tachesimazzoca/retro-devices/usb-sfc-pad/kicad/usb_sfc_pad/3dmodels/0533980271.stp

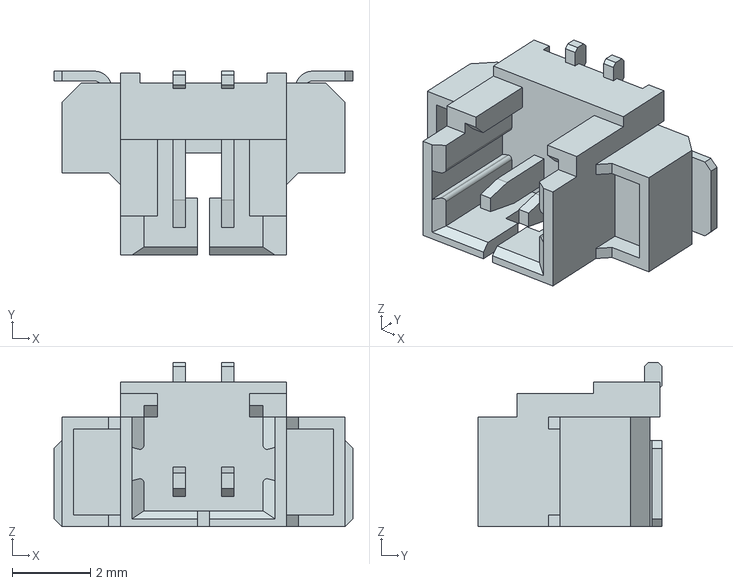
[picture p1: CAD file, 2025-09-26]
usb-sfc-pad/kicad/usb_sfc_pad/3dmodels/0533980271.stp
7.65 x 4.70 x 4.20 mm
