tachesimazzoca/retro-devices/usb-sfc-pad/kicad/usb_sfc_pad/3dmodels/0532610571.stp

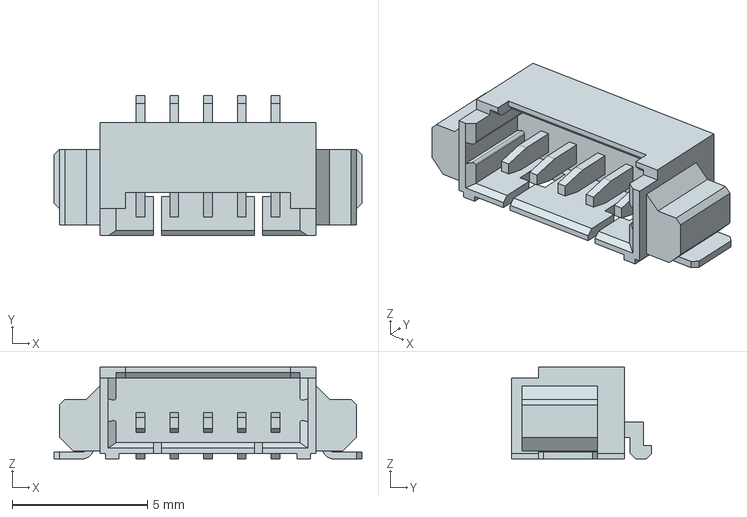
[picture p2: CAD file, 2025-09-26]
usb-sfc-pad/kicad/usb_sfc_pad/3dmodels/0532610571.stp
11.4 x 5.20 x 3.40 mm
