tachesimazzoca/retro-devices/usb-sfc-pad/kicad/usb_sfc_pad/usb_sfc_pad.kicad_pcb

## KiCad design usb-sfc-pad/kicad/usb_sfc_pad/usb_sfc_pad.kicad_pcb (2025-09-27)

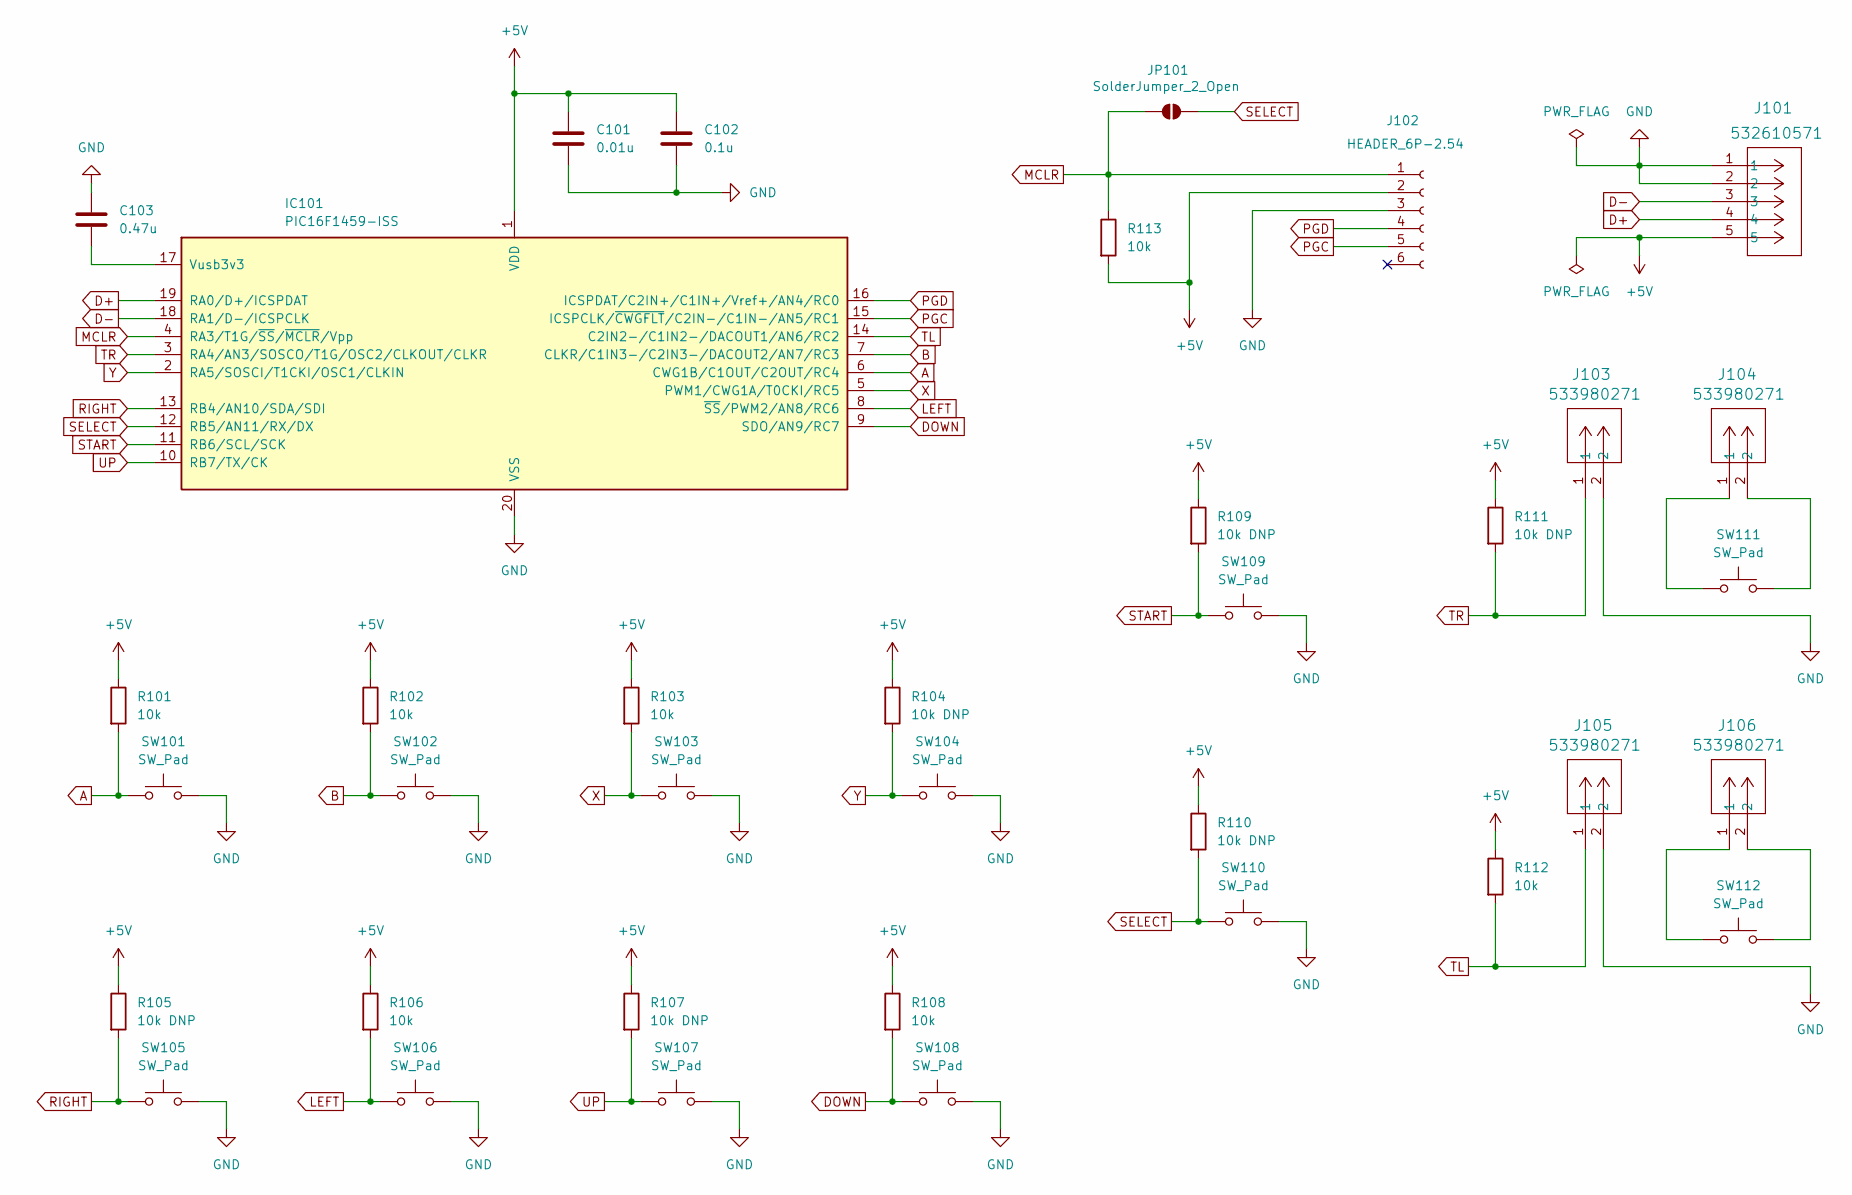
[picture p3: schematic usb_sfc_pad.kicad_sch, USB SFC Pad]

Parts:
C101: 0.01u; C_0402_1005Metric
C102: 0.1u; C_0402_1005Metric
C103: 0.47u; C_0402_1005Metric
IC101: PIC16F1459-ISS; SSOP-20_5.3x7.2mm_P0.65mm
J101: 532610571; CONN_532610001-SD_05_MOL
J102: HEADER_6P-2.54; PinHeader_1x06_P2.54mm_Vertical
J103, J104, J105, J106: 533980271; CONN02_533980271_MOL
JP101: SolderJumper_2_Open; SolderJumper-2_P1.3mm_Open_TrianglePad1.0x1.5mm
R101, R102, R103, R106, R108, R112, R113: 10k; R_0603_1608Metric
R104, R105, R107, R109, R110, R111: 10k DNP; R_0603_1608Metric
SW101, SW102, SW103, SW104, SW105, SW106, SW107, SW108, SW109, SW110, SW111, SW112: SW_Pad; SFC_Pad_F_NoSolder_5.5mm

Connections:
+5V: C101.1, C102.1, IC101.1 (VDD), J101.5, J102.2, R101.1, R102.1, R103.1, R104.1, R105.1, R106.1, R107.1, R108.1, R109.1, R110.1, R111.1, R112.1, R113.2
A: IC101.6 (CWG1B/C1OUT/C2OUT/RC4), R101.2, SW101.2
B: IC101.7 (CLKR/C1IN3-/C2IN3-/DACOUT2/AN7/RC3), R102.2, SW102.2
D+: IC101.19 (RA0/D+/ICSPDAT), J101.4
D-: IC101.18 (RA1/D-/ICSPCLK), J101.3
DOWN: IC101.9 (SDO/AN9/RC7), R108.2, SW108.1
GND: C101.2, C102.2, C103.1, IC101.20 (VSS), J101.1, J101.2, J102.3, J103.2, J105.2, SW101.1, SW102.1, SW103.1, SW104.1, SW105.2, SW106.1, SW107.2, SW108.2, SW109.2, SW110.2
LEFT: IC101.8 (~SS/PWM2/AN8/RC6), R106.2, SW106.2
MCLR: IC101.4 (RA3/T1G/~SS/~MCLR/Vpp), J102.1, JP101.1 (A), R113.1
unnamed: C103.2, IC101.17 (Vusb3v3)
unnamed: J104.1, SW111.1
unnamed: J104.2, SW111.2
unnamed: J106.1, SW112.1
unnamed: J106.2, SW112.2
PGC: IC101.15 (ICSPCLK/~CWGFLT/C2IN-/C1IN-/AN5/RC1), J102.5
PGD: IC101.16 (ICSPDAT/C2IN+/C1IN+/Vref+/AN4/RC0), J102.4
RIGHT: IC101.13 (RB4/AN10/SDA/SDI), R105.2, SW105.1
SELECT: IC101.12 (RB5/AN11/RX/DX), JP101.2 (B), R110.2, SW110.1
START: IC101.11 (RB6/SCL/SCK), R109.2, SW109.1
TL: IC101.14 (C2IN2-/C1IN2-/DACOUT1/AN6/RC2), J105.1, R112.2
TR: IC101.3 (RA4/AN3/SOSCO/T1G/OSC2/CLKOUT/CLKR), J103.1, R111.2
UP: IC101.10 (RB7/TX/CK), R107.2, SW107.1
X: IC101.5 (PWM1/CWG1A/T0CKI/RC5), R103.2, SW103.2
Y: IC101.2 (RA5/SOSCI/T1CKI/OSC1/CLKIN), R104.2, SW104.2

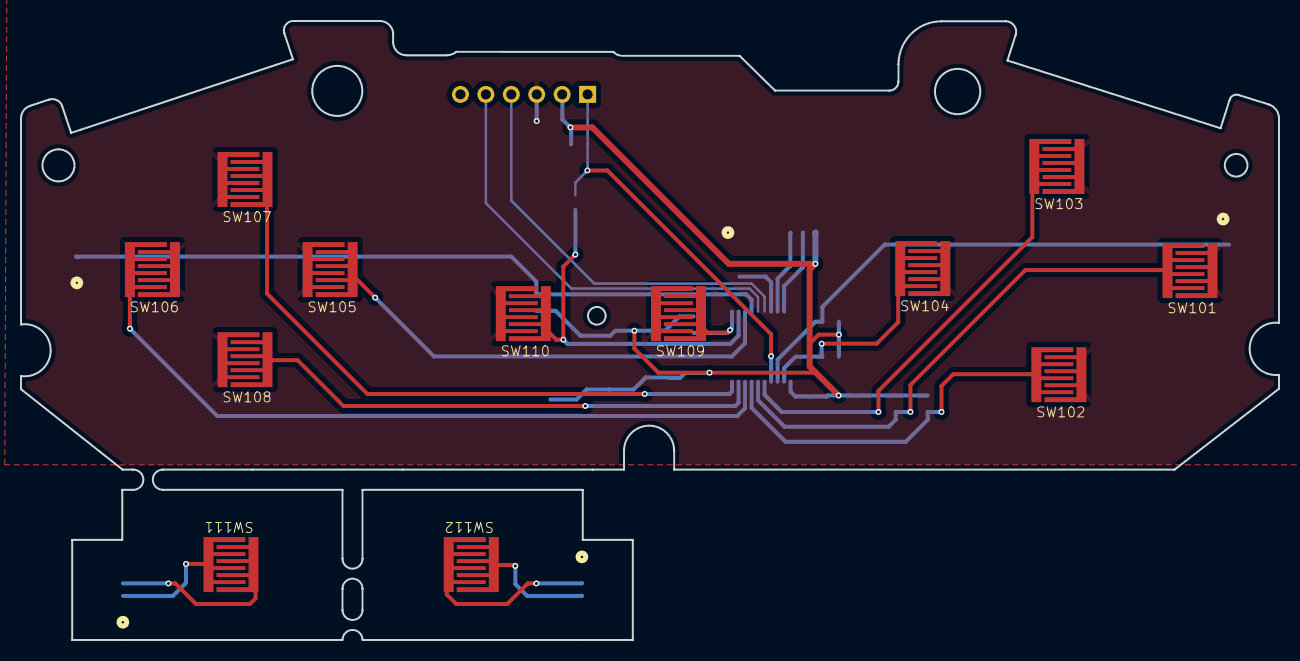
[picture p4: board usb_sfc_pad.kicad_pcb from above]

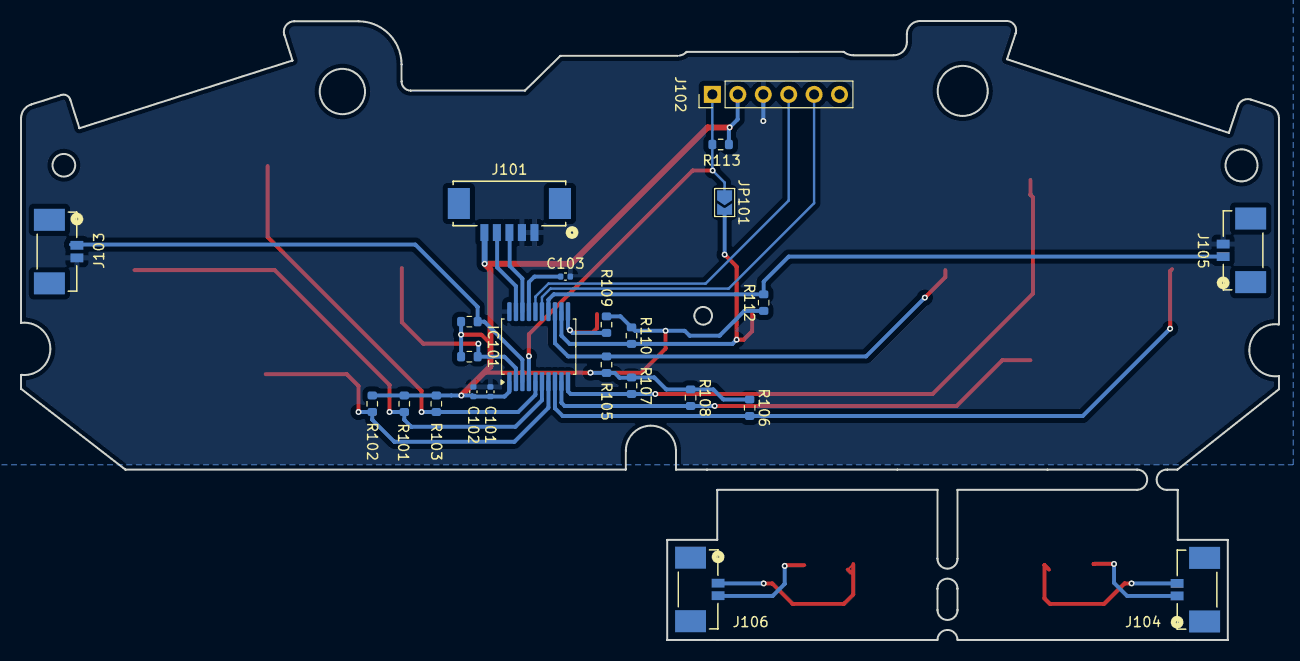
[picture p5: board usb_sfc_pad.kicad_pcb from below]

Board: 2 copper layers, 125.7 x 61.8 mm, 36 parts (24 on the bottom side), 24 nets.
