tachesimazzoca/retro-devices/(commit log)

2025-09-09 Add usb-sfc-pad
    [usb_sfc_pad.kicad_pcb, usb_sfc_pad.kicad_sch]
2025-09-10 Add footprint SFC_Pad
    [usb_sfc_pad.kicad_pcb, usb_sfc_pad.kicad_sch]
2025-09-15 Add PCB
    - Renumber SFC_Pad's pins
    [usb_sfc_pad.kicad_pcb, usb_sfc_pad.kicad_sch]
2025-09-15 Fix clearance in IC101 pads
    [usb_sfc_pad.kicad_pcb, usb_sfc_pad.kicad_sch]
2025-09-15 Add gerber configuration
    [usb_sfc_pad.kicad_pcb]
2025-09-16 Add JLCPCB fabrication files
    [usb_sfc_pad-B_Cu.gbl, usb_sfc_pad-B_Mask.gbs, usb_sfc_pad-B_Paste.gbp, usb_sfc_pad-B_Silkscreen.gbo, usb_sfc_pad-Edge_Cuts.gm1, usb_sfc_pad-F_Cu.gtl, usb_sfc_pad-F_Mask.gts, usb_sfc_pad-F_Paste.gtp]
2025-09-17 Replace 532610671 with 532610571
    [usb_sfc_pad-B_Cu.gbl, usb_sfc_pad-B_Mask.gbs, usb_sfc_pad-B_Paste.gbp, usb_sfc_pad-B_Silkscreen.gbo, usb_sfc_pad-Edge_Cuts.gm1, usb_sfc_pad-F_Cu.gtl, usb_sfc_pad-F_Mask.gts, usb_sfc_pad-F_Paste.gtp]
2025-09-21 Combine LR board
    [usb_sfc_pad-B_Cu.gbl, usb_sfc_pad-B_Mask.gbs, usb_sfc_pad-B_Paste.gbp, usb_sfc_pad-B_Silkscreen.gbo, usb_sfc_pad-Edge_Cuts.gm1, usb_sfc_pad-F_Cu.gtl, usb_sfc_pad-F_Mask.gts, usb_sfc_pad-F_Paste.gtp]
2025-09-24 Replace right-angle 2pins with vertical ones
    [usb_sfc_pad-B_Cu.gbl, usb_sfc_pad-B_Mask.gbs, usb_sfc_pad-B_Paste.gbp, usb_sfc_pad-B_Silkscreen.gbo, usb_sfc_pad-Edge_Cuts.gm1, usb_sfc_pad-F_Cu.gtl, usb_sfc_pad-F_Mask.gts, usb_sfc_pad-F_Paste.gtp]
2025-09-26 Add PicoBlade 3D-models
    [0532610571.stp, 0533980271.stp, usb_sfc_pad.kicad_pcb]
2025-09-27 Fix LR connectors' placement
    [usb_sfc_pad-B_Cu.gbl, usb_sfc_pad-B_Mask.gbs, usb_sfc_pad-B_Paste.gbp, usb_sfc_pad-B_Silkscreen.gbo, usb_sfc_pad-Edge_Cuts.gm1, usb_sfc_pad-F_Cu.gtl, usb_sfc_pad-F_Mask.gts, usb_sfc_pad-F_Paste.gtp]
2025-12-29 Add schematic usb_sfc_pad.svg
